ljparrish/Mobile-Robot/README.md

# Mobile-Robot
Final Project for ME235 - Autonomous Mobile Robot
