ljparrish/Mobile-Robot/MATLAB GUI/GUIFrontPanelScreenshot.png

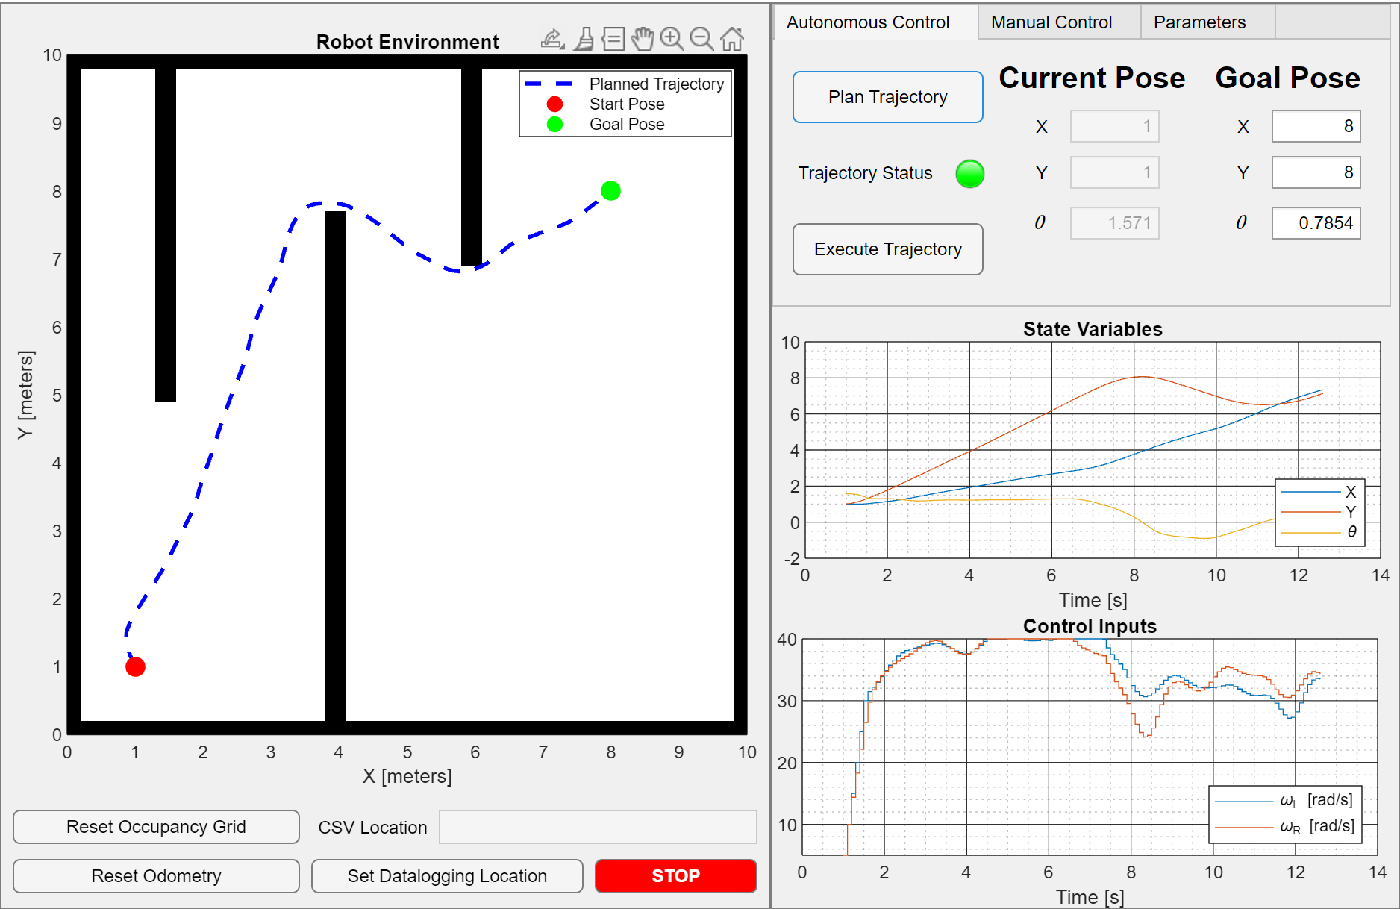
MATLAB GUI/GUIFrontPanelScreenshot.png
