ljparrish/Mobile-Robot/Electrical/Interface-PCBA/Imported Parts/ESP32-S3 Feather/5303 Feather ESP32-S3.step

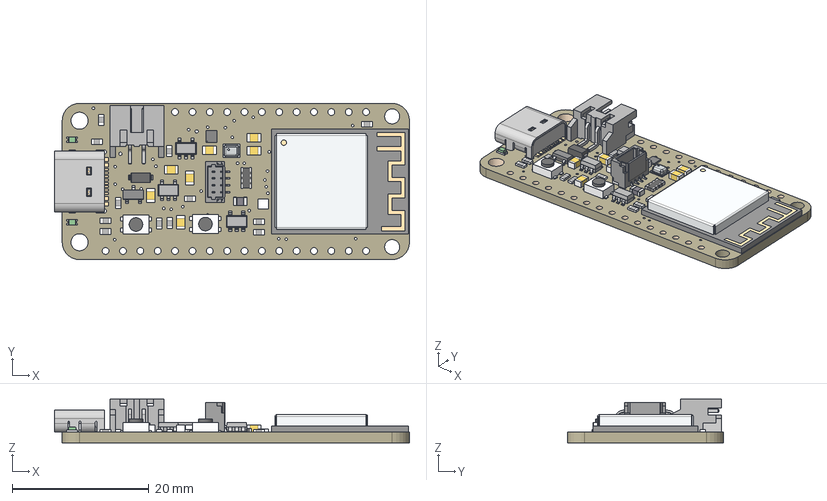
[picture p2: CAD file, 2024-02-23]
Electrical/Interface-PCBA/Imported Parts/ESP32-S3 Feather/5303 Feather ESP32-S3.step
51.9 x 22.9 x 6.37 mm
Board
10uF x 7
AP2112/RT9080-3.3 x 3
MBR540
JSTPH
RED x 2
1uF x 12
KMR2 x 2
DMG3415U
USB C
ESP32-S2-MODULE_MINI
LC709203F/MH
JST SH
WS2812B_SK6805_1515
BME280
10uF_1
10K
