ljparrish/Mobile-Robot/Electrical/Interface-PCBA/Imported Parts/JST-SH-SM04/SM04B-SRSS-TB.STEP

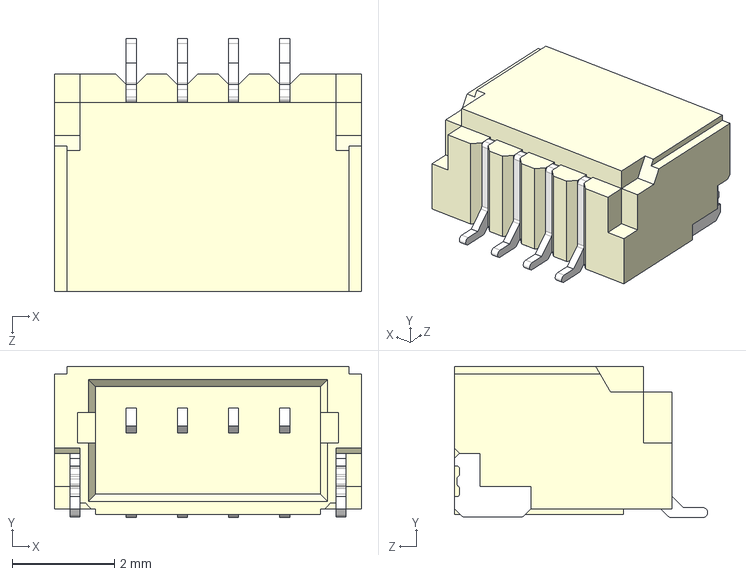
[picture p3: CAD file, 2024-02-29]
Electrical/Interface-PCBA/Imported Parts/JST-SH-SM04/SM04B-SRSS-TB.STEP
6.00 x 2.96 x 4.95 mm
