ljparrish/Mobile-Robot/Electrical/Interface-PCBA/Imported Parts/LT3033/LT3033IUDC_PBF.step

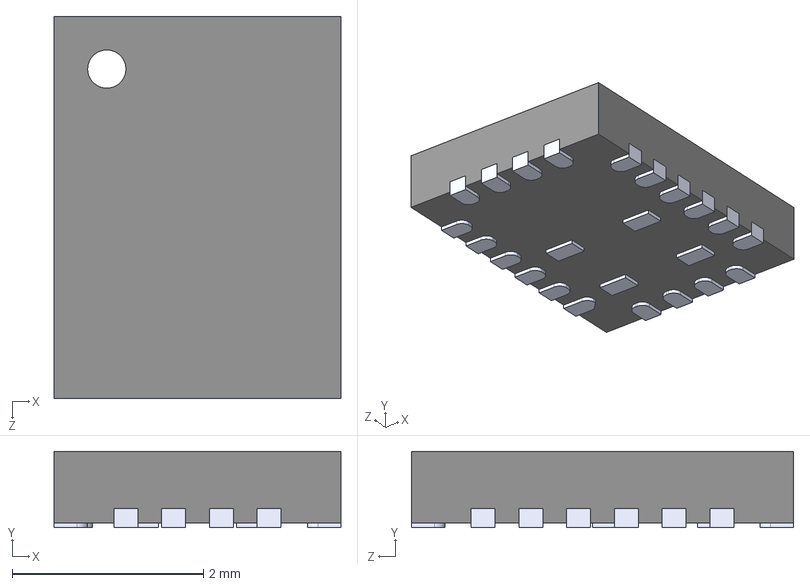
[picture p4: CAD file, 2024-02-23]
Electrical/Interface-PCBA/Imported Parts/LT3033/LT3033IUDC_PBF.step
3.00 x 0.8 x 4.00 mm
