ljparrish/Mobile-Robot/Electrical/Interface-PCBA/Imported Parts/XT60-M/XT60-M.step

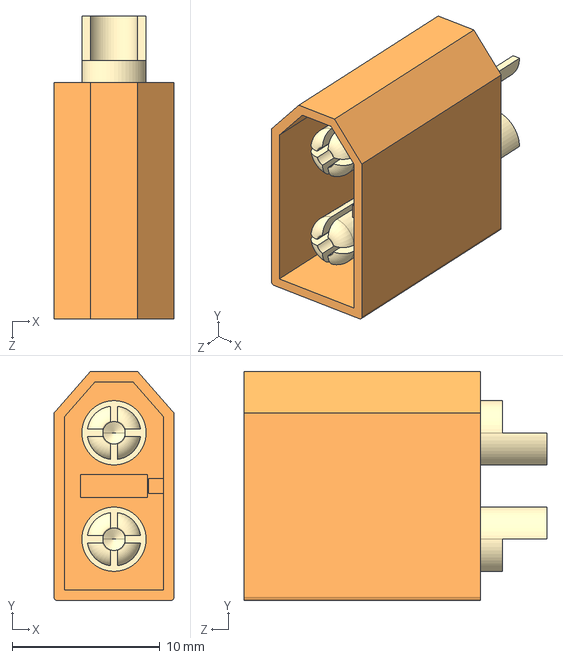
[picture p5: CAD file, 2024-02-23]
Electrical/Interface-PCBA/Imported Parts/XT60-M/XT60-M.step
8.10 x 15.5 x 20.5 mm
