ljparrish/Mobile-Robot/Electrical/Interface-PCBA/Interface-PCBA_Schematic_01.pdf

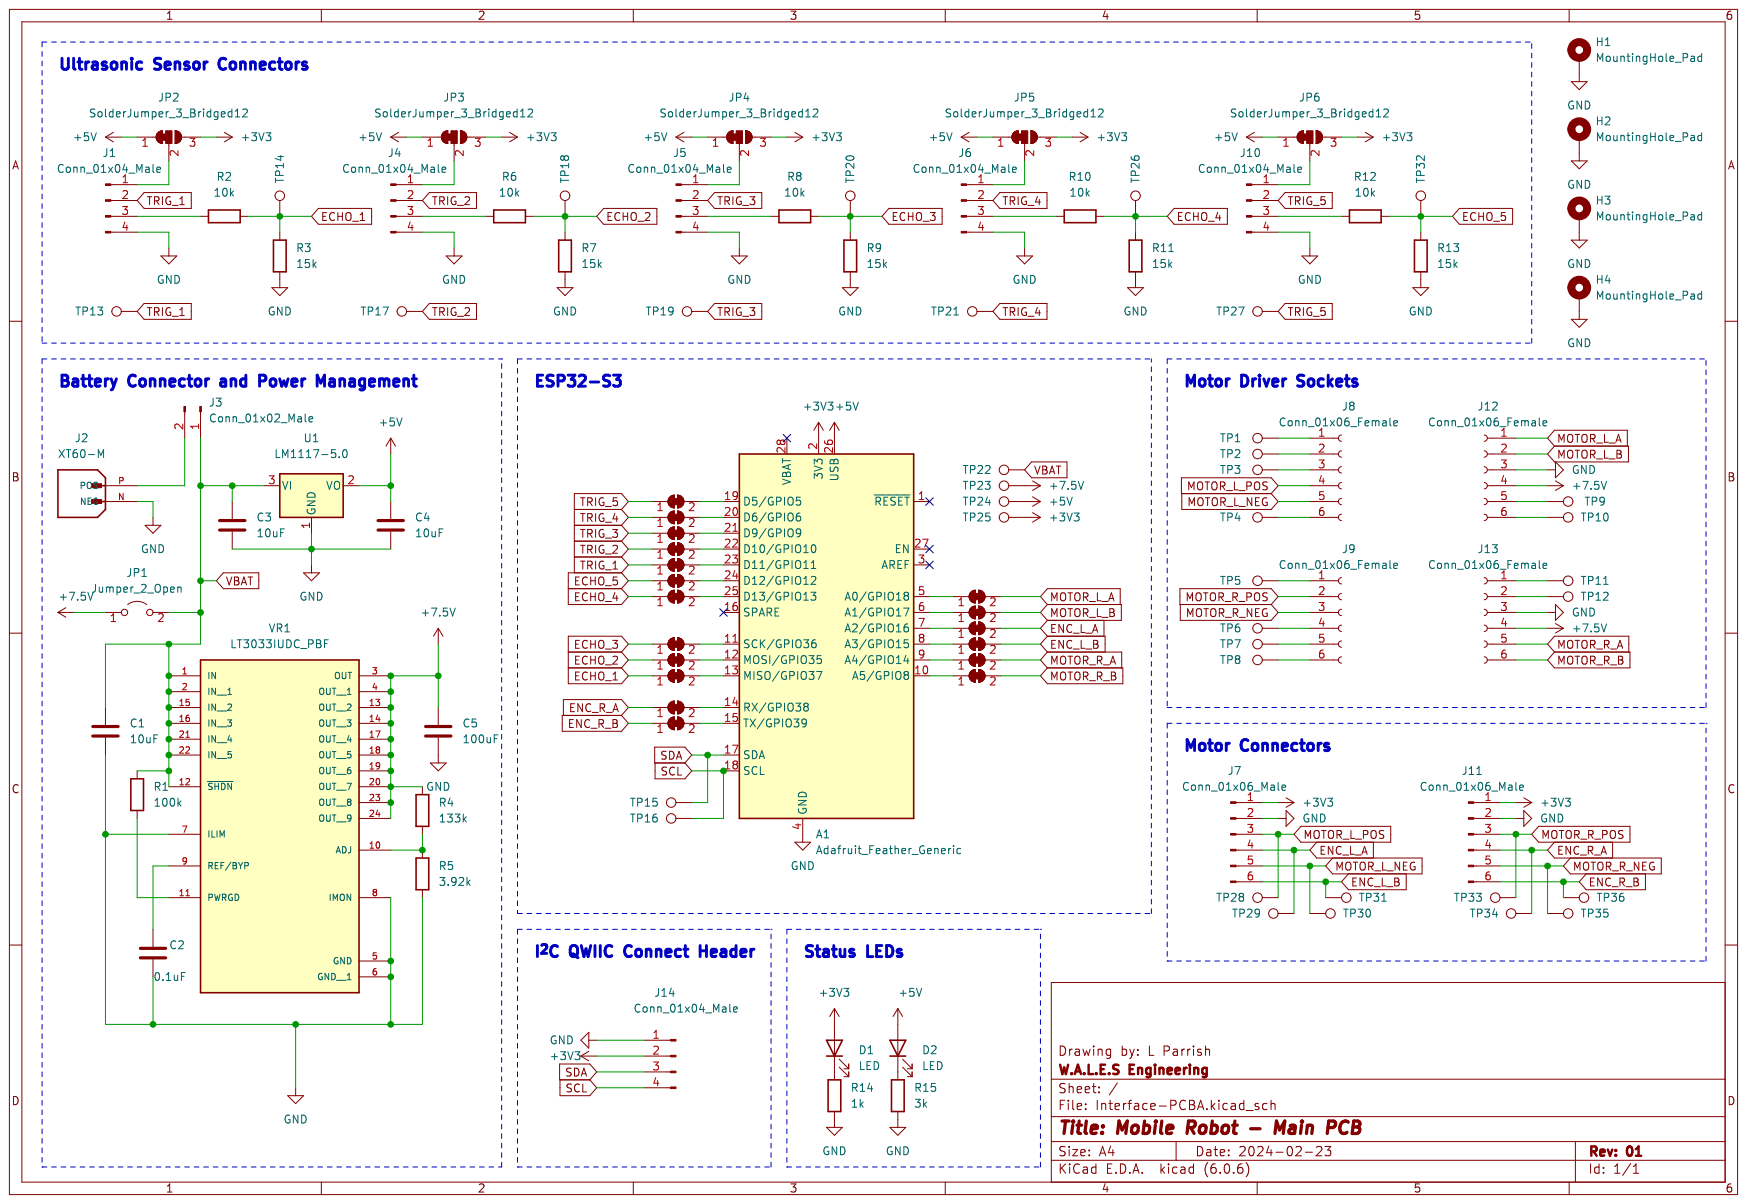
[picture p6: page 1]
