ljparrish/Mobile-Robot/Electrical/Interface-PCBA/Simulation/PowerSupply.asc

C1: cap; 10µF
C2: cap; 100µF
C3: cap; 22µF
C4: cap; 100µF
C5: cap; 10µF
R1: res; 121
R2: res; 556
R3: res; 133k
R4: res; 3.9k
R5: res; 100k
R6: res; 1.7
U1: LT1117
U3: LT3033
V1: voltage; ""
Named nets: 0, VCC
.dc V1 8.4 7.0 0.1
