ljparrish/Mobile-Robot/Electrical/Interface-PCBA/Interface-PCBA.kicad_pcb

## KiCad design Electrical/Interface-PCBA/Interface-PCBA.kicad_pcb (2024-02-29)

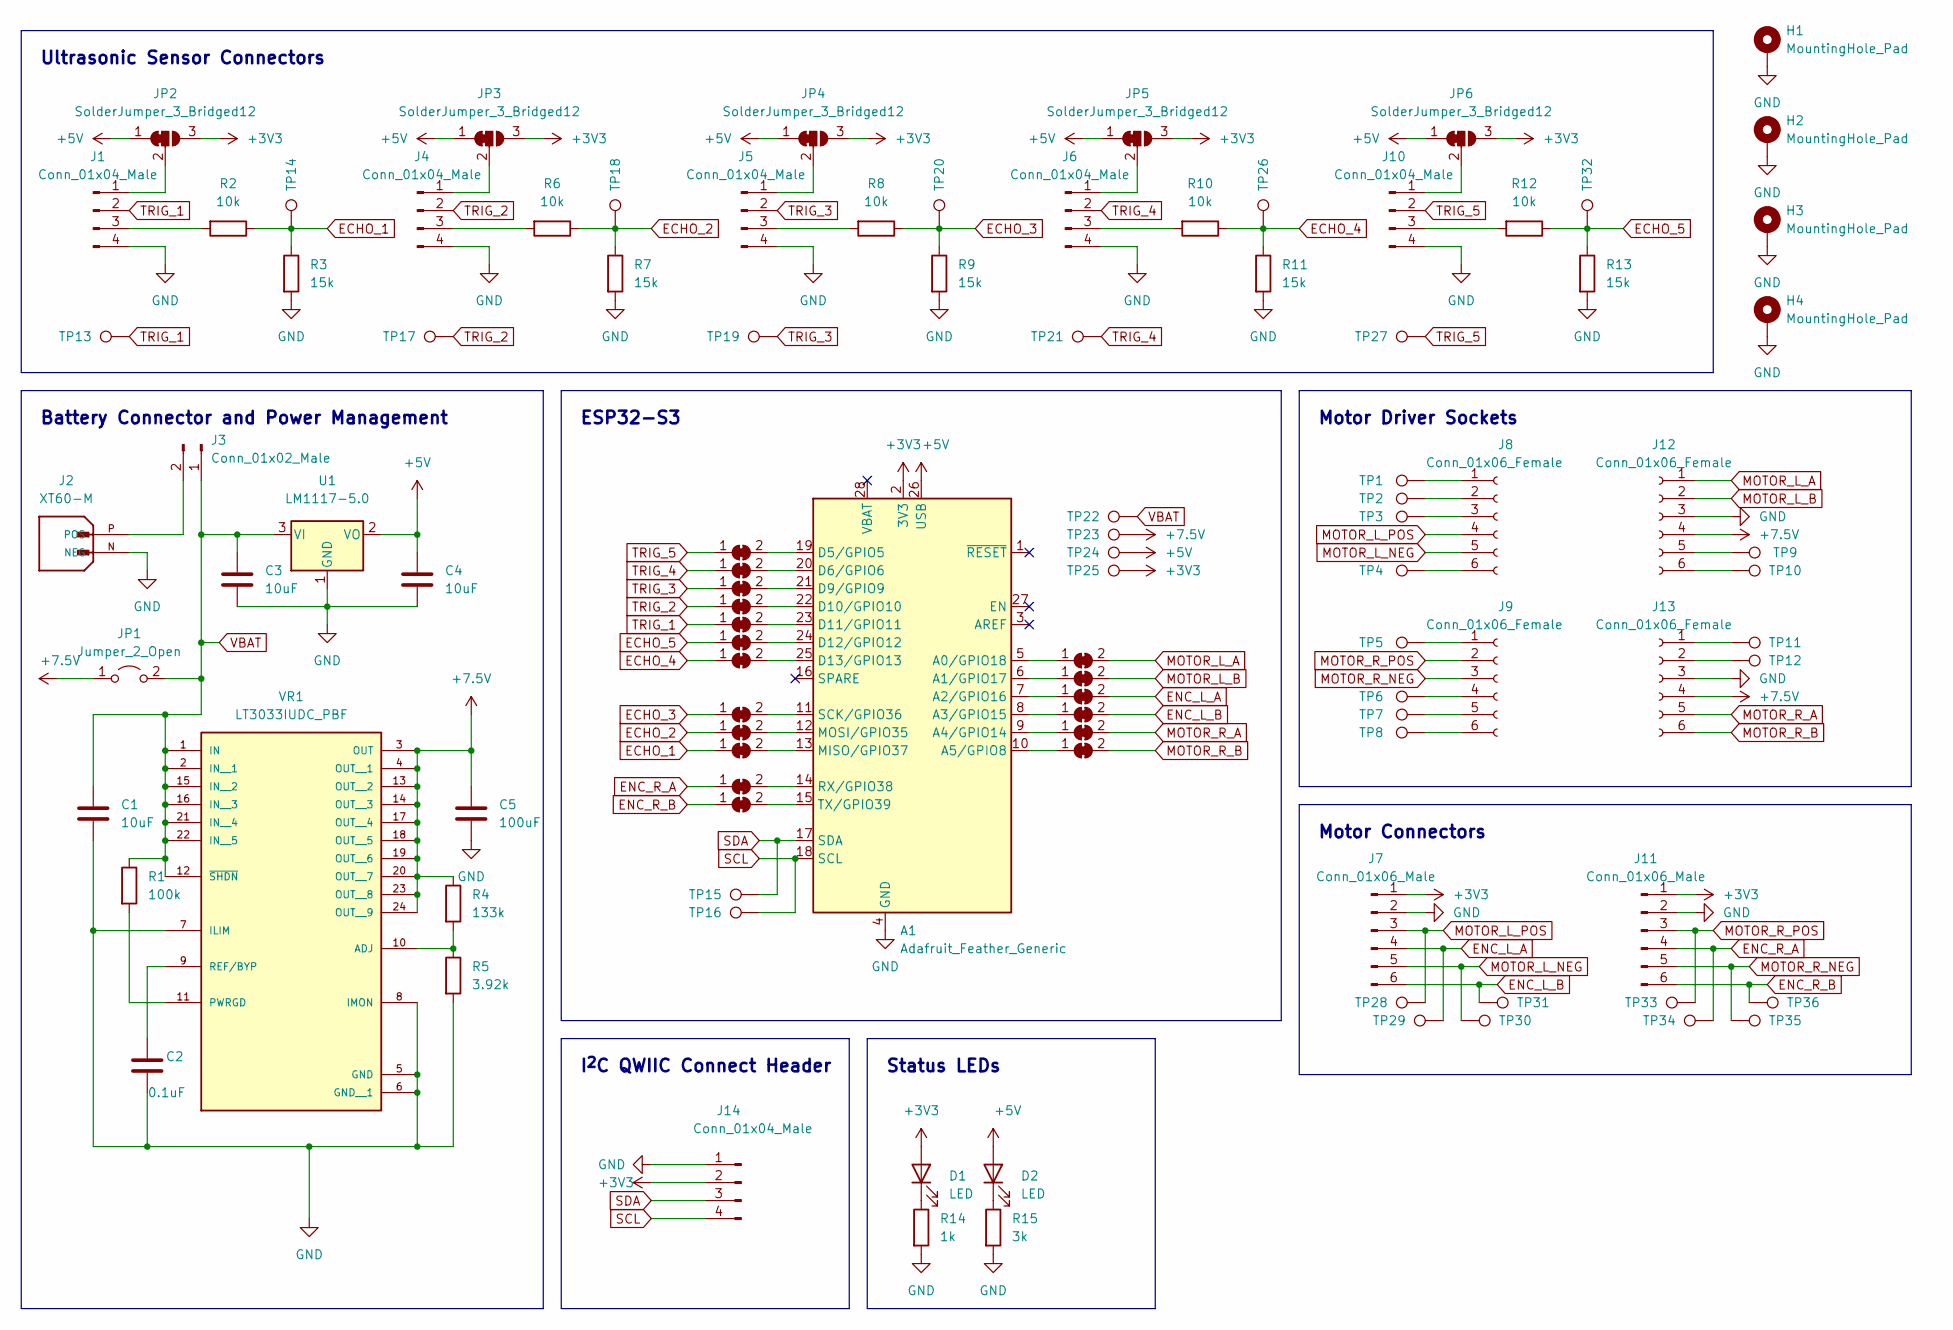
[picture p7: schematic Interface-PCBA.kicad_sch, Mobile Robot - Main PCB]

Parts:
A1: Adafruit_Feather_Generic; Adafruit_Feather
C1, C3, C4: 10uF; CP_EIA-3216-18_Kemet-A
C2: 0.1uF; R_0603_1608Metric
C5: 100uF; CP_EIA-3216-18_Kemet-A
D1, D2: LED; LED_0603_1608Metric_Pad1.05x0.95mm_HandSolder
H1, H2, H3, H4: MountingHole_Pad; MountingHole_3.2mm_M3_DIN965_Pad
J1, J4, J5, J6, J10: Conn_01x04_Male; JST_XH_S4B-XH-A-1_1x04_P2.50mm_Horizontal
J2: XT60-M; AMASS_XT60-M; PARTREV V1.2
J3: Conn_01x02_Male; JST_XH_B2B-XH-A_1x02_P2.50mm_Vertical
J7, J11: Conn_01x06_Male; JST_XH_B6B-XH-A_1x06_P2.50mm_Vertical
J8, J9, J12, J13: Conn_01x06_Female; PinSocket_1x06_P2.54mm_Vertical
J14: Conn_01x04_Male; JST_SH_SM04B-SRSS-TB_1x04-1MP_P1.00mm_Horizontal
JP1: Jumper_2_Open; R_0805_2012Metric
JP2, JP3, JP4, JP5, JP6: SolderJumper_3_Bridged12; SolderJumper-3_P1.3mm_Bridged12_Pad1.0x1.5mm_NumberLabels
JP7, JP8, JP9, JP10, JP11, JP12, JP13, JP14, JP15, JP16, JP17, JP18, JP19, JP20, JP21, JP22, JP23, JP24: SolderJumper_2_Bridged; SolderJumper-2_P1.3mm_Bridged_RoundedPad1.0x1.5mm
R1: 100k; R_0805_2012Metric
R2, R6, R8, R10, R12: 10k; R_0805_2012Metric
R3, R7, R9, R11, R13: 15k; R_0805_2012Metric
R4: 133k; R_0805_2012Metric
R5: 3.92k; R_0805_2012Metric
R14: 1k; R_0805_2012Metric
R15: 3k; R_0805_2012Metric
TP1, TP2, TP3, TP4, TP5, TP6, TP7, TP8, TP9, TP10, TP11, TP12: TestPoint; TestPoint_Pad_D1.5mm
TP13, TP14, TP15, TP16, TP17, TP18, TP19, TP20, TP21, TP22, TP23, TP24, TP25, TP26, TP27, TP28, TP29, TP30, TP31, TP32, TP33, TP34, TP35, TP36: TestPoint; TestPoint_2Pads_Pitch2.54mm_Drill0.8mm
U1: LM1117-5.0; SOT-223
VR1: LT3033IUDC_PBF; VREG_LT3033IUDC_PBF; PARTREV A

Connections:
+3V3: A1.2 (3V3), D1.2 (A), J7.1, J11.1, J14.2, JP2.3 (B), JP3.3 (B), JP4.3 (B), JP5.3 (B), JP6.3 (B), TP25.1
+5V: A1.26 (USB), C4.1, D2.2 (A), JP2.1 (A), JP3.1 (A), JP4.1 (A), JP5.1 (A), JP6.1 (A), TP24.1, U1.2 (VO)
+7.5V: C5.1, J12.4, J13.4, JP1.1 (A), R4.1, TP23.1, VR1.3 (OUT), VR1.4 (OUT__1), VR1.13 (OUT__2), VR1.14 (OUT__3), VR1.17 (OUT__4), VR1.18 (OUT__5), VR1.19 (OUT__6), VR1.20 (OUT__7), VR1.23 (OUT__8), VR1.24 (OUT__9)
ECHO_1: JP16.1 (A), R2.1, R3.1, TP14.1
ECHO_2: JP15.1 (A), R6.1, R7.1, TP18.1
ECHO_3: JP14.1 (A), R8.1, R9.1, TP20.1
ECHO_4: JP13.1 (A), R10.1, R11.1, TP26.1
ECHO_5: JP12.1 (A), R12.1, R13.1, TP32.1
ENC_L_A: J7.4, JP21.2 (B), TP29.1
ENC_L_B: J7.6, JP22.2 (B), TP31.1
ENC_R_A: J11.4, JP17.1 (A), TP34.1
ENC_R_B: J11.6, JP18.1 (A), TP36.1
GND: A1.4 (GND), C1.2, C2.2, C3.2, C4.2, C5.2, H1.1, H2.1, H3.1, H4.1, J1.4, J2.N (NEG), J4.4, J5.4, J6.4, J7.2, J10.4, J11.2, J12.3, J13.3, J14.1, R3.2, R5.2, R7.2, R9.2, R11.2, R13.2, R14.2, R15.2, U1.1 (GND), VR1.5 (GND), VR1.6 (GND__1), VR1.7 (ILIM), VR1.8 (IMON)
MOTOR_L_A: J12.1, JP19.2 (B)
MOTOR_L_B: J12.2, JP20.2 (B)
MOTOR_L_NEG: J7.5, J8.5, TP30.1
MOTOR_L_POS: J7.3, J8.4, TP28.1
MOTOR_R_A: J13.5, JP23.2 (B)
MOTOR_R_B: J13.6, JP24.2 (B)
MOTOR_R_NEG: J9.3, J11.5, TP35.1
MOTOR_R_POS: J9.2, J11.3, TP33.1
unnamed: A1.5 (A0/GPIO18), JP19.1 (A)
unnamed: A1.6 (A1/GPIO17), JP20.1 (A)
unnamed: A1.7 (A2/GPIO16), JP21.1 (A)
unnamed: A1.8 (A3/GPIO15), JP22.1 (A)
unnamed: A1.9 (A4/GPIO14), JP23.1 (A)
unnamed: A1.10 (A5/GPIO8), JP24.1 (A)
unnamed: A1.11 (SCK/GPIO36), JP14.2 (B)
unnamed: A1.12 (MOSI/GPIO35), JP15.2 (B)
unnamed: A1.13 (MISO/GPIO37), JP16.2 (B)
unnamed: A1.14 (RX/GPIO38), JP17.2 (B)
unnamed: A1.15 (TX/GPIO39), JP18.2 (B)
unnamed: A1.19 (D5/GPIO5), JP7.2 (B)
unnamed: A1.20 (D6/GPIO6), JP8.2 (B)
unnamed: A1.21 (D9/GPIO9), JP9.2 (B)
unnamed: A1.22 (D10/GPIO10), JP10.2 (B)
unnamed: A1.23 (D11/GPIO11), JP11.2 (B)
unnamed: A1.24 (D12/GPIO12), JP12.2 (B)
unnamed: A1.25 (D13/GPIO13), JP13.2 (B)
unnamed: C2.1, VR1.9 (REF/BYP)
unnamed: D1.1 (K), R14.1
unnamed: D2.1 (K), R15.1
unnamed: J1.1, JP2.2 (C)
unnamed: J1.3, R2.2
unnamed: J2.P (POS), J3.2
unnamed: J4.1, JP3.2 (C)
unnamed: J4.3, R6.2
unnamed: J5.1, JP4.2 (C)
unnamed: J5.3, R8.2
unnamed: J6.1, JP5.2 (C)
unnamed: J6.3, R10.2
unnamed: J8.1, TP1.1
unnamed: J8.2, TP2.1
unnamed: J8.3, TP3.1
unnamed: J8.6, TP4.1
unnamed: J9.1, TP5.1
unnamed: J9.4, TP6.1
unnamed: J9.5, TP7.1
unnamed: J9.6, TP8.1
unnamed: J10.1, JP6.2 (C)
unnamed: J10.3, R12.2
unnamed: J12.5, TP9.1
unnamed: J12.6, TP10.1
unnamed: J13.1, TP11.1
unnamed: J13.2, TP12.1
unnamed: R1.2, VR1.11 (PWRGD)
unnamed: R4.2, R5.1, VR1.10 (ADJ)
SCL: A1.18 (SCL), J14.4, TP16.1
SDA: A1.17 (SDA), J14.3, TP15.1
TRIG_1: J1.2, JP11.1 (A), TP13.1
TRIG_2: J4.2, JP10.1 (A), TP17.1
TRIG_3: J5.2, JP9.1 (A), TP19.1
TRIG_4: J6.2, JP8.1 (A), TP21.1
TRIG_5: J10.2, JP7.1 (A), TP27.1
VBAT: C1.1, C3.1, J3.1, JP1.2 (B), R1.1, TP22.1, U1.3 (VI), VR1.1 (IN), VR1.2 (IN__1), VR1.12 (~SHDN), VR1.15 (IN__2), VR1.16 (IN__3), VR1.21 (IN__4), VR1.22 (IN__5)

Notes on the sheet:
I^{2}C QWIIC Connect Header
Status LEDs
Motor Connectors
Battery Connector and Power Management
ESP32-S3
Ultrasonic Sensor Connectors
Motor Driver Sockets

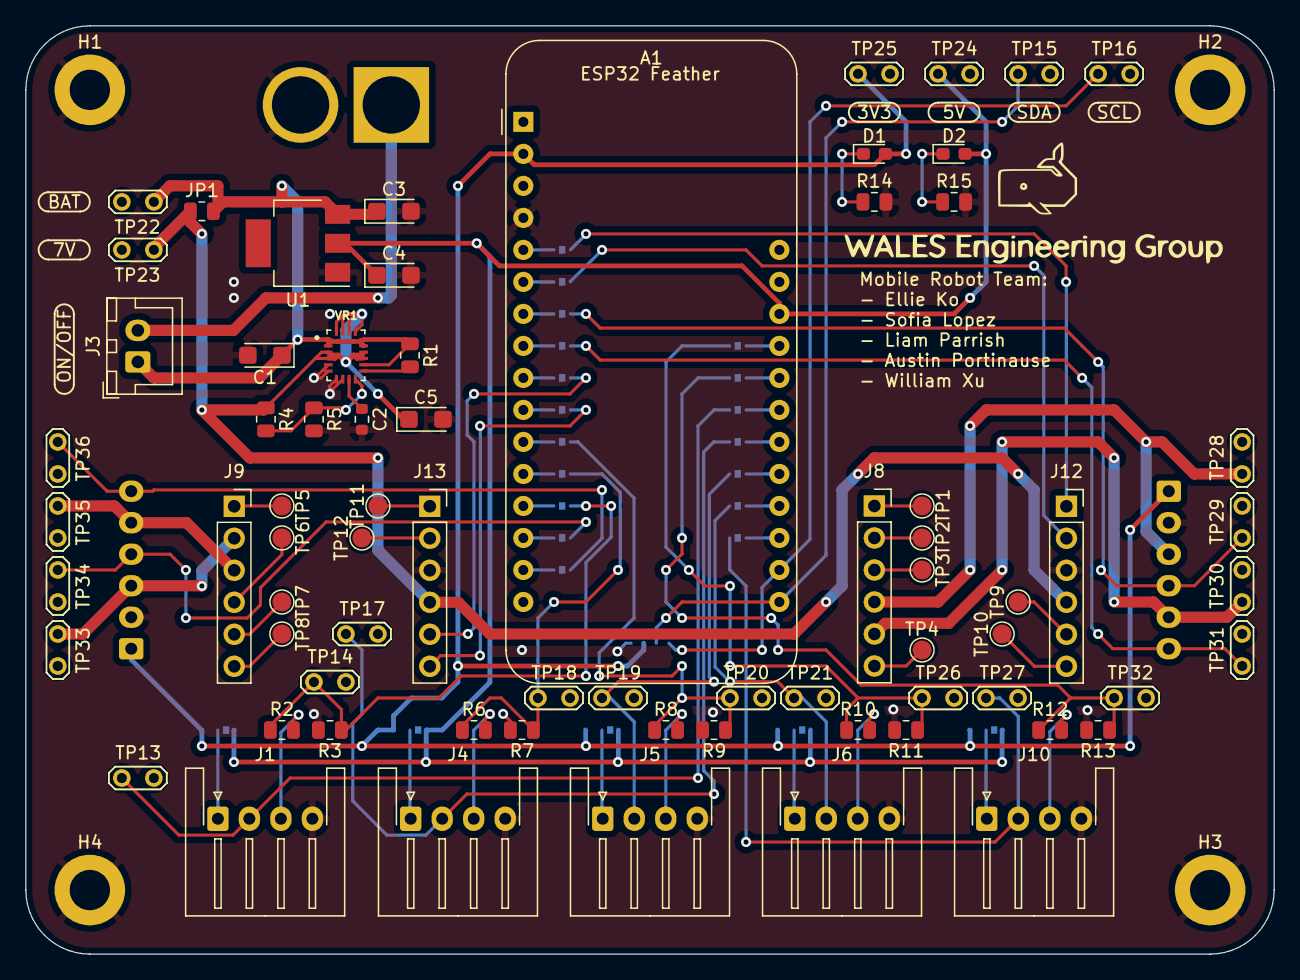
[picture p8: board Interface-PCBA.kicad_pcb from above]

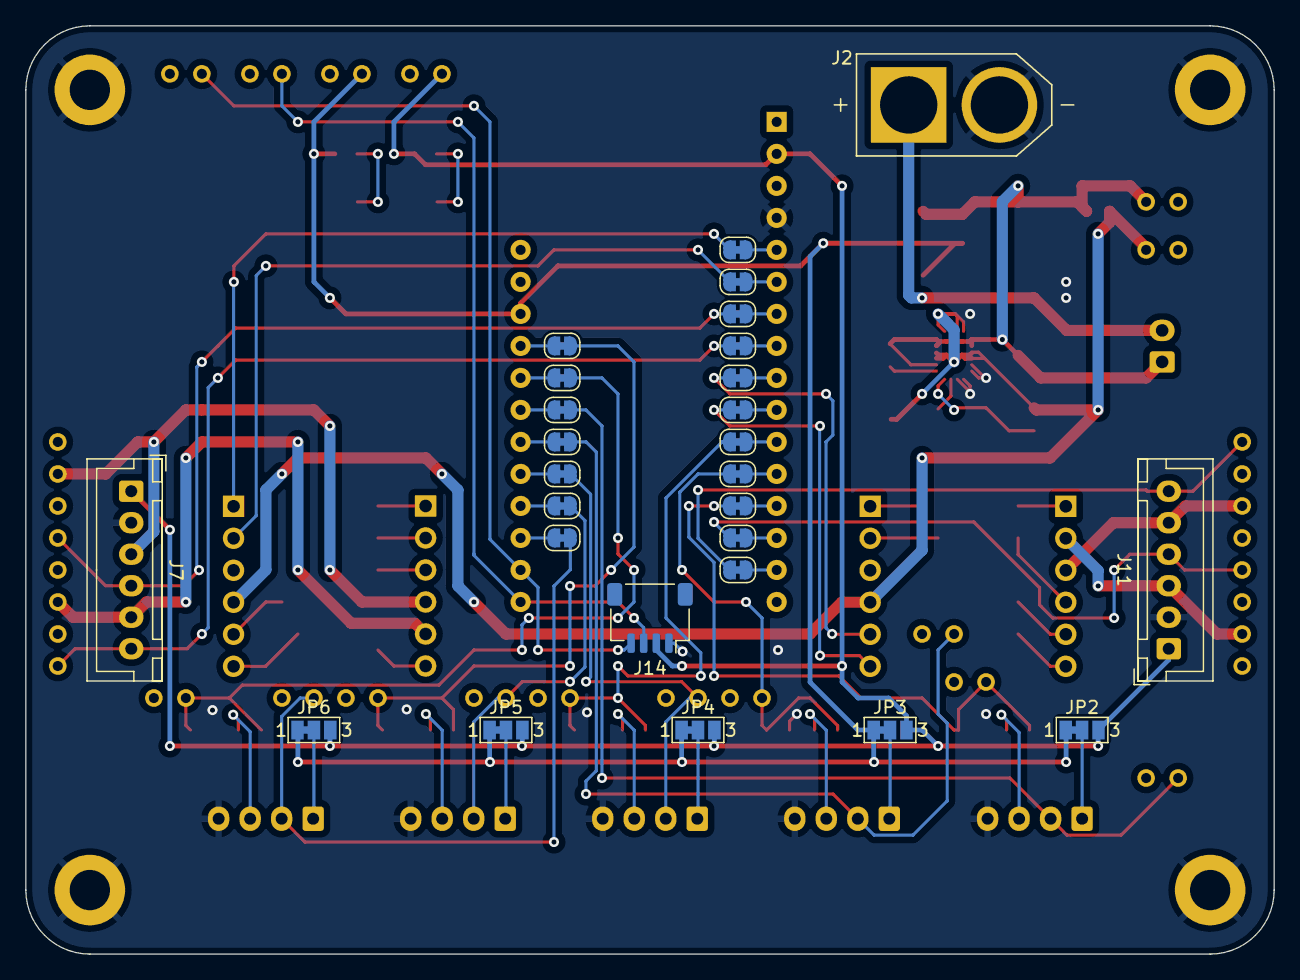
[picture p9: board Interface-PCBA.kicad_pcb from below]

Board: 2 copper layers, 99.1 x 73.7 mm, 103 parts (27 on the bottom side), 75 nets.
