ljparrish/Mobile-Robot/Embedded-SW/mobile-robot-main/components/ultrasonic/ultrasonic.c

/*
 * Copyright (c) 2016 Ruslan V. Uss <unclerus@gmail.com>
 *
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
 * THIS SOFTWARE IS PROVIDED BY THE COPYRIGHT HOLDERS AND CONTRIBUTORS "AS IS"
 * AND ANY EXPRESS OR IMPLIED WARRANTIES, INCLUDING, BUT NOT LIMITED TO, THE
 * IMPLIED WARRANTIES OF MERCHANTABILITY AND FITNESS FOR A PARTICULAR PURPOSE ARE
 * DISCLAIMED. IN NO EVENT SHALL THE COPYRIGHT HOLDER OR CONTRIBUTORS BE LIABLE
 * FOR ANY DIRECT, INDIRECT, INCIDENTAL, SPECIAL, EXEMPLARY, OR CONSEQUENTIAL
 * DAMAGES (INCLUDING, BUT NOT LIMITED TO, PROCUREMENT OF SUBSTITUTE GOODS OR
 * SERVICES; LOSS OF USE, DATA, OR PROFITS; OR BUSINESS INTERRUPTION) HOWEVER
 * CAUSED AND ON ANY THEORY OF LIABILITY, WHETHER IN CONTRACT, STRICT LIABILITY,
 * OR TORT (INCLUDING NEGLIGENCE OR OTHERWISE) ARISING IN ANY WAY OUT OF THE USE
 * OF THIS SOFTWARE, EVEN IF ADVISED OF THE POSSIBILITY OF SUCH DAMAGE.
 */

/**
 * @file ultrasonic.c
 *
 * ESP-IDF driver for ultrasonic range meters, e.g. HC-SR04, HY-SRF05 and the like
 *
 * Ported from esp-open-rtos
 *
 * Copyright (c) 2016 Ruslan V. Uss <unclerus@gmail.com>
 *
 * BSD Licensed as described in the file LICENSE
 */
#include <esp_idf_lib_helpers.h>
#include "ultrasonic.h"
#include <freertos/FreeRTOS.h>
#include <freertos/task.h>
#include <esp_timer.h>
#include <ets_sys.h>

#define TRIGGER_LOW_DELAY 4
#define TRIGGER_HIGH_DELAY 10
#define PING_TIMEOUT 6000
#define ROUNDTRIP_CM 58

#if HELPER_TARGET_IS_ESP32
static portMUX_TYPE mux = portMUX_INITIALIZER_UNLOCKED;
#define PORT_ENTER_CRITICAL portENTER_CRITICAL(&mux)
#define PORT_EXIT_CRITICAL portEXIT_CRITICAL(&mux)

#elif HELPER_TARGET_IS_ESP8266
#define PORT_ENTER_CRITICAL portENTER_CRITICAL()
#define PORT_EXIT_CRITICAL portEXIT_CRITICAL()

#else
#error cannot identify the target
#endif

#define timeout_expired(start, len) ((esp_timer_get_time() - (start)) >= (len))

#define CHECK_ARG(VAL)                  \
    do                                  \
    {                                   \
        if (!(VAL))                     \
            return ESP_ERR_INVALID_ARG; \
    } while (0)
#define CHECK(x)                \
    do                          \
    {                           \
        esp_err_t __;           \
        if ((__ = x) != ESP_OK) \
            return __;          \
    } while (0)
#define RETURN_CRITICAL(RES) \
    do                       \
    {                        \
        PORT_EXIT_CRITICAL;  \
        return RES;          \
    } while (0)

esp_err_t ultrasonic_init(const ultrasonic_sensor_t *dev)
{
    CHECK_ARG(dev);

    CHECK(gpio_set_direction(dev->trigger_pin, GPIO_MODE_OUTPUT));
    CHECK(gpio_set_direction(dev->echo_pin, GPIO_MODE_INPUT));

    return gpio_set_level(dev->trigger_pin, 0);
}

esp_err_t ultrasonic_measure_raw(const ultrasonic_sensor_t *dev, uint32_t max_time_us, uint32_t *time_us)
{
    CHECK_ARG(dev && time_us);

    PORT_ENTER_CRITICAL;

    // Ping: Low for 2..4 us, then high 10 us
    CHECK(gpio_set_level(dev->trigger_pin, 0));
    ets_delay_us(TRIGGER_LOW_DELAY);
    CHECK(gpio_set_level(dev->trigger_pin, 1));
    ets_delay_us(TRIGGER_HIGH_DELAY);
    CHECK(gpio_set_level(dev->trigger_pin, 0));

    // Previous ping isn't ended
    if (gpio_get_level(dev->echo_pin))
        RETURN_CRITICAL(ESP_ERR_ULTRASONIC_PING);

    // Wait for echo
    int64_t start = esp_timer_get_time();
    while (!gpio_get_level(dev->echo_pin))
    {
        if (timeout_expired(start, PING_TIMEOUT))
            RETURN_CRITICAL(ESP_ERR_ULTRASONIC_PING_TIMEOUT);
    }

    // got echo, measuring
    int64_t echo_start = esp_timer_get_time();
    int64_t time = echo_start;
    while (gpio_get_level(dev->echo_pin))
    {
        time = esp_timer_get_time();
        if (timeout_expired(echo_start, max_time_us))
        {
            *time_us = max_time_us;
            PORT_EXIT_CRITICAL;
            return ESP_OK;
        }
    }
    PORT_EXIT_CRITICAL;
    *time_us = time - echo_start;
    return ESP_OK;
}

esp_err_t ultrasonic_measure_cm(const ultrasonic_sensor_t *dev, uint32_t max_distance, uint32_t *distance)
{
    CHECK_ARG(dev && distance);

    uint32_t time_us;
    CHECK(ultrasonic_measure_raw(dev, max_distance * ROUNDTRIP_CM, &time_us));

    // Calculate distance in centimeters
    uint32_t dist_cm = time_us / ROUNDTRIP_CM;

    // Check if distance exceeds 255, if so, cap it at 255
    if (dist_cm > 255)
    {
        *distance = 255;
    }
    else
    {
        *distance = dist_cm;
    }
    return ESP_OK;
}
