ljparrish/Mobile-Robot/Embedded-SW/mobile-robot-dongle/main/uart.c

#include <stdio.h>
#include "freertos/FreeRTOS.h"
#include "freertos/task.h"
#include "driver/gpio.h"
#include "esp_log.h"
#include "sdkconfig.h"
#include "driver/uart.h"
#include "string.h"

#define ECHO_TEST_TXD (GPIO_NUM_10)
#define ECHO_TEST_RXD (GPIO_NUM_9)
#define ECHO_TEST_RTS (UART_PIN_NO_CHANGE)
#define ECHO_TEST_CTS (UART_PIN_NO_CHANGE)

#define ECHO_UART_PORT_NUM      (UART_NUM_1)
#define ECHO_UART_BAUD_RATE     (115200)
#define ECHO_TASK_STACK_SIZE    (2048)

static const char *UART_TAG = "UART TEST";

#define BUF_SIZE (1024)

static void echo_task(void * arg)
{
    // Setup UART Parameters
    uart_config_t uart_config = {
        .baud_rate = ECHO_UART_BAUD_RATE,
        .data_bits = UART_DATA_8_BITS,
        .parity = UART_PARITY_DISABLE,
        .stop_bits = UART_STOP_BITS_1,
        .flow_ctrl = UART_HW_FLOWCTRL_DISABLE,
        .source_clk = UART_SCLK_DEFAULT,
    };
    int intr_alloc_flags= 0;

    // Install and Initialize the UART Drivers
    ESP_ERROR_CHECK(uart_driver_install(ECHO_UART_PORT_NUM, BUF_SIZE * 2, 0, 0, NULL, intr_alloc_flags));
    ESP_ERROR_CHECK(uart_param_config(ECHO_UART_PORT_NUM, &uart_config));
    ESP_ERROR_CHECK(uart_set_pin(ECHO_UART_PORT_NUM, ECHO_TEST_TXD, ECHO_TEST_RXD, ECHO_TEST_RTS, ECHO_TEST_CTS));

    // Configure a temporary buffer for the incoming data
    uint8_t *data = (uint8_t *) malloc(BUF_SIZE);

    while (1)
    {
        // Read UART Data
        int len = uart_read_bytes(ECHO_UART_PORT_NUM, data, (BUF_SIZE - 1), 20 / portTICK_PERIOD_MS);
        // Write back to UART
        uart_write_bytes(ECHO_UART_PORT_NUM, (const char *) data, len);

        if (len) {
            data[len] = '\0';
        }
    } 
}

void stream_task(void * arg)
{
    // Setup UART Parameters
    uart_config_t uart_config = {
        .baud_rate = ECHO_UART_BAUD_RATE,
        .data_bits = UART_DATA_8_BITS,
        .parity = UART_PARITY_DISABLE,
        .stop_bits = UART_STOP_BITS_1,
        .flow_ctrl = UART_HW_FLOWCTRL_DISABLE,
        .source_clk = UART_SCLK_DEFAULT,
    };
    int intr_alloc_flags= 0;

    // Install and Initialize the UART Drivers
    ESP_ERROR_CHECK(uart_driver_install(ECHO_UART_PORT_NUM, BUF_SIZE * 2, 0, 0, NULL, intr_alloc_flags));
    ESP_ERROR_CHECK(uart_param_config(ECHO_UART_PORT_NUM, &uart_config));
    ESP_ERROR_CHECK(uart_set_pin(ECHO_UART_PORT_NUM, ECHO_TEST_TXD, ECHO_TEST_RXD, ECHO_TEST_RTS, ECHO_TEST_CTS));

     // Configure a temporary buffer for the incoming data
    uint8_t *data = (uint8_t *) malloc(BUF_SIZE);
    uint8_t test_data = 0;

    while (1) {
        memcpy(data, &test_data, sizeof(test_data));
        // Write data back to the UART
        uart_write_bytes(ECHO_UART_PORT_NUM, (const char *) data, sizeof(test_data));
        ESP_LOGI(UART_TAG, "Data Sent: %i", test_data);
        test_data++;
        vTaskDelay(pdMS_TO_TICKS(1000));
    }
    
}

void uart_setup(void)
{
    // Setup UART Parameters
    uart_config_t uart_config = {
        .baud_rate = ECHO_UART_BAUD_RATE,
        .data_bits = UART_DATA_8_BITS,
        .parity = UART_PARITY_DISABLE,
        .stop_bits = UART_STOP_BITS_1,
        .flow_ctrl = UART_HW_FLOWCTRL_DISABLE,
        .source_clk = UART_SCLK_DEFAULT,
    };
    int intr_alloc_flags= 0;

    // Install and Initialize the UART Drivers
    ESP_ERROR_CHECK(uart_driver_install(ECHO_UART_PORT_NUM, BUF_SIZE * 2, 0, 0, NULL, intr_alloc_flags));
    ESP_ERROR_CHECK(uart_param_config(ECHO_UART_PORT_NUM, &uart_config));
    ESP_ERROR_CHECK(uart_set_pin(ECHO_UART_PORT_NUM, ECHO_TEST_TXD, ECHO_TEST_RXD, ECHO_TEST_RTS, ECHO_TEST_CTS));

}
