ljparrish/Mobile-Robot/Embedded-SW/mobile-robot-main/main/led_blink.c

#include <stdio.h>
#include "freertos/FreeRTOS.h"
#include "freertos/task.h"
#include "driver/gpio.h"
#include "esp_log.h"
#include "led_strip.h"
#include "sdkconfig.h"
#include "include/mobile_robot_pins.h"

static const char *LED_TAG = "LED";

#define BLINK_GPIO NEOPIXEL_ADDRESS

static uint8_t s_led_state = 0;
static led_strip_handle_t led_strip;

static void blink_led()
{
    /* If the addressable LED is enabled */
    if (s_led_state) {
        /* Set the LED pixel using RGB from 0 (0%) to 255 (100%) for each color */
        led_strip_set_pixel(led_strip, 0, 16, 32, 16);
        /* Refresh the strip to send data */
        led_strip_refresh(led_strip);
    } else {
        /* Set all LED off to clear all pixels */
        led_strip_clear(led_strip);
    }
}

static void configure_led()
{
    ESP_LOGI(LED_TAG, "Example configured to blink addressable LED!");
    /* LED strip initialization with the GPIO and pixels number*/
    gpio_reset_pin(NEOPIXEL_POWER);
    gpio_set_direction(NEOPIXEL_POWER, GPIO_MODE_OUTPUT);
    gpio_set_level(NEOPIXEL_POWER, 1); // Sets neopixel power pin high
    led_strip_config_t strip_config = {
        .strip_gpio_num = BLINK_GPIO,
        .max_leds = 1, // at least one LED on board
    };
    led_strip_rmt_config_t rmt_config = {
        .resolution_hz = 10 * 1000 * 1000, // 10MHz
    };
    ESP_ERROR_CHECK(led_strip_new_rmt_device(&strip_config, &rmt_config, &led_strip));
    /* Set all LED off to clear all pixels */
    led_strip_clear(led_strip);
}
