ljparrish/Mobile-Robot/Embedded-SW/mobile-robot-main/pytest_blink.py

# SPDX-FileCopyrightText: 2022 Espressif Systems (Shanghai) CO LTD
# SPDX-License-Identifier: CC0-1.0

import logging
import os

import pytest
from pytest_embedded_idf.dut import IdfDut


@pytest.mark.supported_targets
@pytest.mark.generic
def test_blink(dut: IdfDut) -> None:
    # check and log bin size
    binary_file = os.path.join(dut.app.binary_path, 'mobile-robot-main.bin')
    bin_size = os.path.getsize(binary_file)
    logging.info('bin_size : {}KB'.format(bin_size // 1024))
