ljparrish/Mobile-Robot/(commit log)

2024-02-23 Interface PCB Rev 1
    Created first iteration of PCB for connecting ESP32 to periphrials
    [5303 Feather ESP32-S3.step, Interface-PCBA.kicad_pcb, Interface-PCBA.kicad_sch, LT3033IUDC_PBF.step, XT60-M.step]
2024-02-29 PCB Design
    Finished PCB design and sent out for fabrication
    [Interface-PCBA-B_Cu.gbr, Interface-PCBA-B_Mask.gbr, Interface-PCBA-B_Paste.gbr, Interface-PCBA-B_Silkscreen.gbr, Interface-PCBA-Edge_Cuts.gbr, Interface-PCBA-F_Cu.gbr, Interface-PCBA-F_Mask.gbr, Interface-PCBA-F_Paste.gbr]
2024-03-10 Updates to PCBA BOM files
    [BOM.csv, Bill of Materials.xlsx]
2024-03-12 rotary encoder example
    edited example from ESP IDF
2024-03-14 Updated Unicycle model with wheel velocity inputs
2024-03-20 Got 2 encoders working!
    rotary_encoder_example_main: the pure example from ESP documentation for reading encoder pulses, one wheel.
    encoder_example_trim_down: trim down ESP example to get rid of unnecessary items. Added accum count, counts total pulses, no more watch points.
    two_wheels_encoder_reading: outputs accum count for encoder pulses for two wheels. Resets count to 0 at each time interval. USE THIS ONE for main file.
    multitasking_try1: skeleton code for multitasking from this youtube video :https://www.youtube.com/watch?v=bEhZp4Adghc
    [encoder_example_trim_down.c, multitasking_try1.c, rotary_encoder_example_main.c, two_wheels_encoder_reading.c]
2024-03-21 Setup Embedded Systems Project Folder
    - Added skeleton for main mobile robot script with RTOS multitasking
    - Added basic LED blink task
    - Added header file for PCB pinout
2024-03-21 Added Motor Control
    - Added motor control and PID libraries
    - Made basic motor control ramp function
2024-03-26 Implemented Motor PID
    - Added Sofia's code for encoder measurement
    - Added encoder measurement Queue for sending data
    - Added motor closed loop control
2024-04-02 Started setting up ESPNOW wireless code
2024-04-03 ESP NOW Updates
    - Finished first pass of ESPNOW code for mobile robot
    - Currently sends test data that increments in software
2024-04-03 Add simple state estimation
    - Not complete
    - Comments share the issue to be fixed
    [state_estimation.py]
2024-04-07 Add the code used to test algorithms
    - Tested state estimation in Python and C
    - Tested three ultrasonic sensor measurement
2024-04-07 Move state estimation macros below encoder macros
2024-04-09 Created USB dongle ESP-IDF Project
    Setup project folder for USB wireless dongle using ESP32-C3
2024-04-09 Fix state estimation initialization issue and add scaling factor
    [main.c, motor_control.c]
2024-04-09 Started UART.c File
2024-04-09 Add ultrasonic sensor measurement task
2024-04-09 Update main.c
    - Added code to output MAC Address of ESP32
2024-04-13 UART Debugging
2024-04-14 Simplified basic UART Test
2024-04-16 Dongle UART and Wireless
    - Added UART configuration for dongle
    - Updated ESP NOW structure to be smaller
    - Wrote task functions and setup queues for 2 way data transmission
2024-04-16 Wireless Control
    - Added robot side motor command queue
    - Updated ESP NOW robot code
2024-04-17 Changes to ESPNOW delays
    - Tweaked motor PID gains
2024-04-17 testing occupancy grid
    testing
    [Book1.csv]
2024-04-18 Remove TODO (no compile error)
    [main.c]
2024-04-18 Change ultrasonic sensors order
2024-04-18 Added ultrasonic values to ESP NOW transmission
2024-04-19 Add populating occupancy grid with dummy ultrasonic sensor measurements
2024-04-19 Update motor_control.c
    - Added open loop test routine
2024-04-21 Added timer callback functions to GUI
2024-04-21 System ID for DC motor
    - Gathered data for system ID of the DC motor
    - Fit motor model to experimental data
2024-04-21 Edits to main for motor testing
2024-04-22 Added DC Motor Feedforward
    - Added new feedforward commands
    - Implemented in main
2024-04-22 Updated PID Gains
2024-04-23 Update PID Control to stop robot if it loses connection
2024-04-24 Fixed mobile robot transmitting odometry
    [main.c]
2024-04-24 Update motor_control.c
    - Updated robot initial position
2024-04-26 Updated GUI
    Updated the manual control tab to include a control switch rather than a button to start and disable manual control
2024-04-26 Update motor_control.c
    - Changed scaling factors
2024-04-27 Update ultrasonic sensor measurement to detect non-occupancy and fix typos
    [main.c, ultrasonic.c]
2024-04-27 Updated Motor Control
2024-04-27 Update main.c
    Changed PID from incremental to positional
2024-04-30 Started new branch with timer interrupt
2024-05-01 Edit ultrasonic sensor measurements (max range, timeout)
2024-05-01 Fix ultrasonic sensor's the max range to 255
    [main.c, ultrasonic.c]
